Schnibbz/yeti-paw/cnc/yeti-paw-v1.3-yoke-CNC-drawing.pdf

BOTTOM face (engraved), as worn — legs up, eye down

yeti-paw-v1.3-yoke-CNC.step · mm (model frame: x along the U, y across)

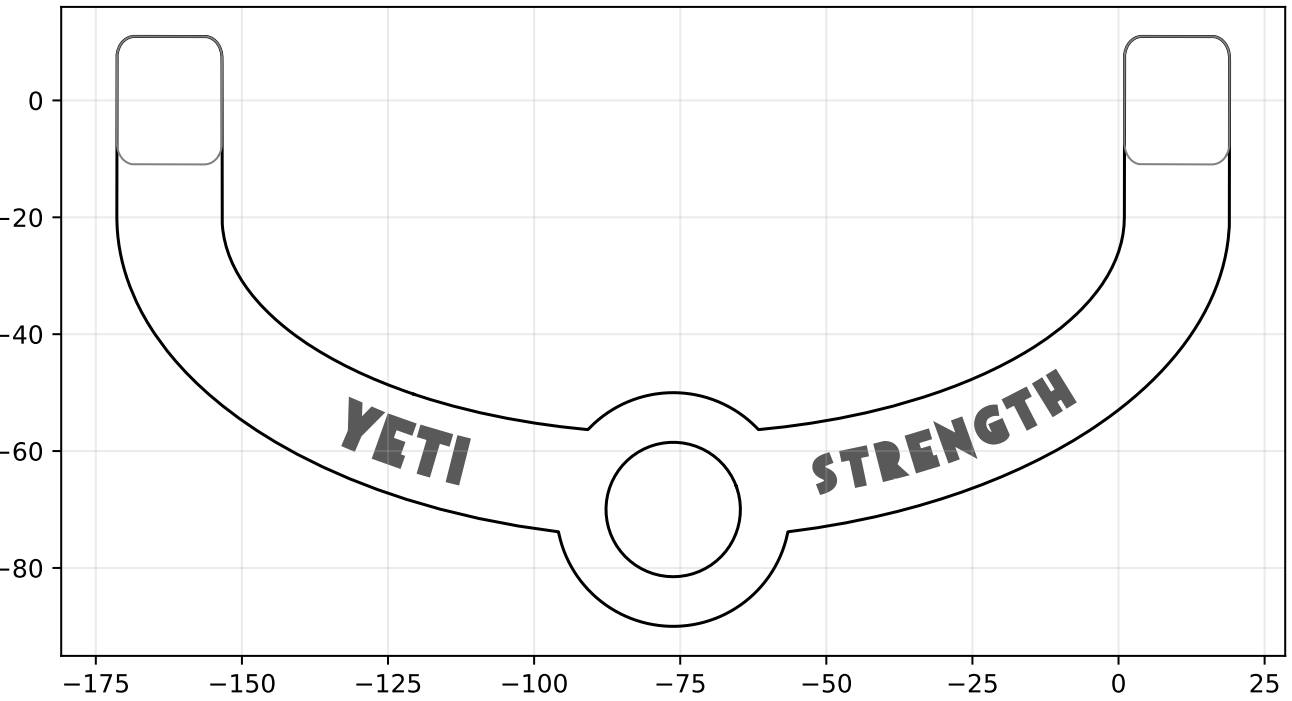
[picture p5: figure]

−25 | 0 | 25 | 50 | 75 | 100 | 125 | 150 | 175

0

20

Section through the pivot axis (x = 0) both Ø12 bores coaxial

Feature | Size | Notes
Pivot bores (2) | Ø12.000 P7 (11.971 / 11.989) | horizontal, through each boss, COAXIAL ±0.05
Pivot axis height | 13.00 from bottom face | boss Ø26, R3 end edges
Boss inner faces | 154.41 ±0.10 apart | sit 1 mm off the plates
Boss outer faces | 190.41 ±0.20
Eye bore | Ø23.000 P7 (22.965 / 22.986) | thru, centre 70.0 from pivot axis
Eye flange c'bore | Ø30.40 +0.10/0 × 1.60 deep | TOP face (opposite the engraving)
Band | 18 wide × 12.7 thick | R3 on every edge
YETI STRENGTH | engrave 0.30 ±0.05 | BOTTOM face, ≥ 2 mm off the radii

NOTES
1. Material: 6061-T6 aluminium. Overall 103 × 190.4 × 26 mm — from ≥ 28 mm (1-1/8" or 1-1/4") plate. Quantity 1.
2. Unless stated: ISO 2768-mK. Break all other edges 0.2–0.5 mm, no burrs. The R3 on every edge and the round bosses need 3D (ball-end) work on both faces;
a 4th axis or a side setup drills the two horizontal pivot bores — they MUST be coaxial (one setup, or line-bore).
3. Sleeves (purchased, same as the printed yoke): 2 × SF-1 steel-backed 12 × 10 × 20 in the pivot bores, pressed 1 mm proud of each boss face;
1 × bronze flanged 20 × 23 × 12, flange Ø30 × 1.5, in the eye, flange up in its counterbore. P7 bores = light press; bearing-retainer compound OK in aluminium.
4. Finish (optional): bead blast or tumble, then anodize Type II. Mask or hold the three sleeve bores after finishing; keep media out of them.
5. Engraving: YETI STRENGTH (Yeti Strength wordmark), 0.3 deep on the bottom face, reading as worn (legs up). Ø1 end mill or V-bit; strokes ≈ 1.5 mm.
6. Strength: at the 75 lb rating the yoke stress is ≈ 10 MPa (same FE as the printed yoke) → 6061-T6 static SF ≈ 28, fatigue SF ≈ 10.
The printed pad dowel still limits the rating to 75 lb. Not professionally engineered — use at your own risk.

YETI PAW v1.3 — carabiner yoke, CNC version (machined 6061-T6) Designed by Schnibbz · YETI STRENGTH
