Schnibbz/yeti-paw/cnc/yeti-paw-v1.3-plates-CNC-drawing.pdf

LEFT plate — OUTER face view (seats + engraving)

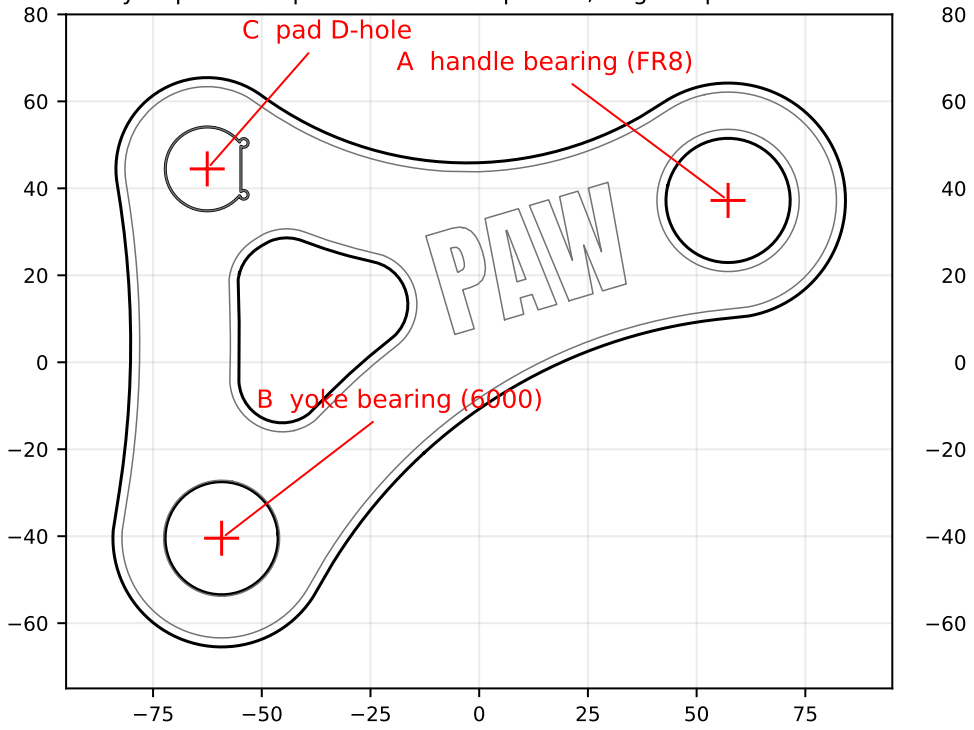
[picture p6: figure]
pad D-hole; B yoke bearing (6000); A handle bearing (FR8)

yeti-paw-v1.3-plate-left-CNC.step · mm, origin = part centre

RIGHT plate — OUTER face view (seats + engraving)

yeti-paw-v1.3-plate-right-CNC.step · mm, origin = part centre

Feature | Size | Depth from OUTER face
A FR8 flange c'bore | Ø32.05 +0.10/0 | 1.90 +0.05/0
A FR8 bearing seat | Ø28.575 K7 (28.560 / 28.581) | 7.94 +0.05/0

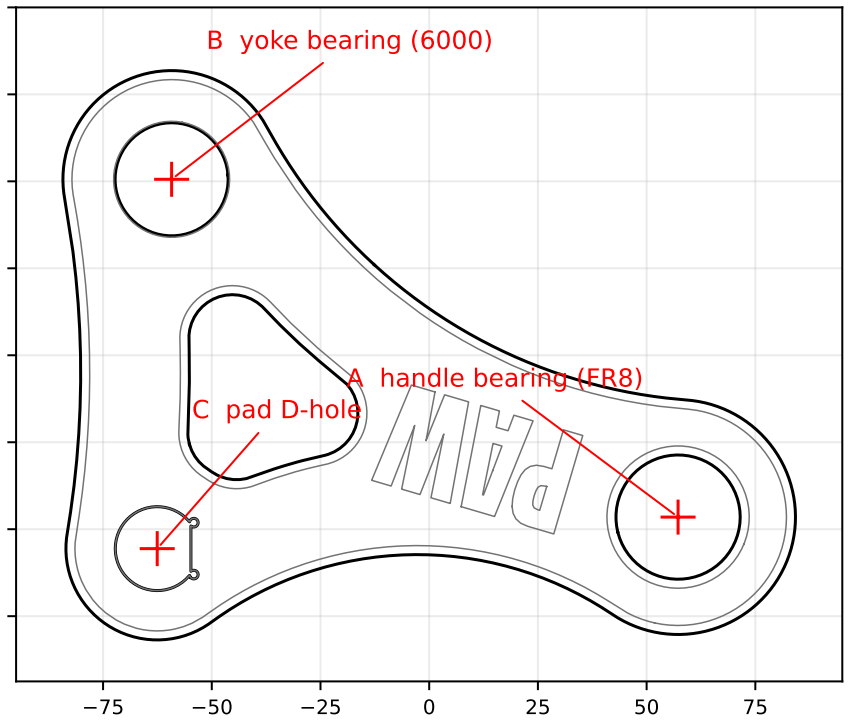
[picture p7: figure]
pad D-hole; B yoke bearing (6000); A handle bearing (FR8)

A through | Ø21.0 | thru
B 6000 bearing seat | Ø26.000 K7 (25.985 / 26.006) | 8.00 +0.05/0
B through | Ø17.0 | thru
A, B seat mouths | 0.5 × 45° lead-in | at outer face
C pad D-hole | Ø19.30 +0.10/0 | thru
C D flat | 7.75 +0.05/0 from hole centre | thru
C D corners | 2 × Ø2.0 relief (dogbone) | thru
Outline + window | R3 both faces
PAW logo | engrave | 0.30 ±0.05

Bearing-centre distances (functional, ±0.05):

A–C: 120.00

A–B: 140.00

B–C: 85.00

Bearings are pressed in from the OUTER face. Seat floors are flat, max corner radius 0.3 (the bearings' own edge chamfer). The FR8 locates on its seat floor, not on its flange.

NOTES
1. Material: 6061-T6 aluminium plate, 10.0 mm thick (±0.1). Do not substitute 3/8" (9.53 mm): the plate thickness sets the handle stack and the printed dowel's fit.
2. Quantity: 1 LEFT + 1 RIGHT. They are MIRROR IMAGES, not two of the same part.
3. Unless stated: ISO 2768-mK (±0.2 on most sizes, ±0.3 on the outline). Break all other edges 0.2–0.5 mm, no burrs, no sharp edges (the plates are handled and touch the forearm).
4. Edge radius: R3 on the outline and window, both faces. A 1 × 45° chamfer instead is acceptable if it saves a setup or cost — state it on the quote.
5. Finish (optional, quote separately): bead blast or vibratory tumble, THEN anodize Type II (black). Mask both bearing seats, or hold the seat sizes AFTER finishing:

anodizing grows the surface, which tightens a K7 seat. Keep tumbling media out of the seats.
6. Bearings: FR8-2RS (12.7 × 28.575 × 7.94, flange Ø31.75 × 1.6) in A; 6000-2RS (10 × 26 × 8) in B. Press square with an arbor press on the OUTER ring only.
7. Engraving: PAW, 0.3 deep. Strokes are > 2 mm wide; a Ø2 end mill or a V-bit is fine (inside corners may round).
8. These plates replace the printed side plates only. Everything else (printed yoke and pad dowel, hardware) is per the YETI PAW v1.3 BOM. The published safety factors
are for PETG-CF printed parts. Aluminium plates are much stronger, but the printed yoke and dowel still limit the rating to 75 lb. Not professionally engineered — use at your own risk.

YETI PAW v1.3 — side plates, CNC version (machined aluminium) Designed by Schnibbz · YETI STRENGTH
