Schnibbz/yeti-paw/BOM-yeti-paw.md

# YETI PAW v1.3 — Lateral Raise Handle — Bill of Materials

Designed by **Schnibbz** · YETI STRENGTH

> ## ⚠️ Parts changed in v1.3
> **Two parts are different from v1.2. Buy the new ones: the old ones don't fit the v1.3 files, and the new ones don't fit v1.2 prints.**
>
> | Part | v1.2 (old) | **v1.3 (new)** | Why |
> |---|---|---|---|
> | **Handle bearing** · 2 per handle · both plate variants | FR8-2RS **flanged**, 1/2" × 1-1/8" × 5/16" | **R8-2RS plain** (no flange), same 1/2" × 1-1/8" × 5/16" | The press fit alone holds the bearing; the flange did nothing. Cheaper, and the plate loses its flange pocket and the support it needed. |
> | **Carabiner eye sleeve** · 1 per yoke | uxcell **wrapped** flanged sleeve, 20 × 23 × 10 mm, Ø30 flange | **Solid bronze plain sleeve**, 3/4" bore × 7/8" OD × 1/2" long (McMaster **6391K256**) | The wrapped sleeve pressed in out of round and left the bottom edge of the eye bare plastic where the carabiner bears. The solid sleeve stays round and sits flush on both faces, so the carabiner only touches bronze. |
>
> **Don't mix versions.** v1.3 plates have no flange pocket, so an FR8 won't seat flush. The v1.3 yoke's eye bore is Ø22.39 for the 7/8" sleeve:
> the old 23 mm sleeve won't press in, and the new sleeve would be loose in a v1.2 yoke. Everything else is unchanged.

## What it costs

| | One Yeti Paw | A pair (both arms) |
|---|---|---|
| **Parts cost, pro-rated** — what the parts in one unit cost; packs split across the units they build; no tax; raw handles | **≈ $72** | **≈ $144** |
| **Cash to buy everything for a pair** — whole packs, no tax, plenty of hardware and filament left over | — | **≈ $217** |
| **What my first batch actually cost** — 4 units, real receipts, incl. tax and anodized handles | **$86.22** | **$172.44** |

How the first batch got from ≈ $72 of parts per unit to $86.22: sales tax, anodized handles instead of raw ($58 vs $48 a pair), and the
spare bearings, nuts, sleeves and ~600 g of filament left over from whole packs. Prices are approximate, checked 2026-10-13 for v1.2, and will drift. They have not been re-priced for v1.3's two part changes (the R8 bearing is cheaper; the bronze sleeve adds a McMaster-Carr order).

**Assumes free Rogue shipping**: Rogue ships free once your cart has 3 ship-free items, so add the handles to a bigger Rogue
order (or a friend's). Other shipping is included in the parts cost: Bolt Depot economy $12.12 and aluminumspacers.com $10
flat, both split across a pair. Amazon is free over $35.

Quantities below are **per Yeti Paw** (one handle). Double them for a pair.

## Amazon

*Amazon links are affiliate links (I earn a small commission at no extra cost to you). Prices change, so they aren't listed.*

| Part | Qty | Pack | Link |
|---|---|---|---|
| **Handle bearing** · *changed in v1.3*<br><sub>R8-2RS plain ball bearing (no flange), 1/2" bore × 1-1/8" OD × 5/16" — Sackorange 10-pack</sub> | 2 | 10 | [B07DCQLCS3](https://www.amazon.com/dp/B07DCQLCS3?tag=yetistrength-20) |
| **Yoke bearing**<br><sub>6000-2RS ball bearing, 10 × 26 × 8 mm</sub> | 2 | 10 | [B0DTKDKSTF](https://www.amazon.com/dp/B0DTKDKSTF?tag=yetistrength-20) |
| **Yoke compression sleeve**<br><sub>SF-1 1020 bushing, 10 × 12 × 20 mm</sub> | 2 | 10 | [B07FPH25F3](https://www.amazon.com/dp/B07FPH25F3?tag=yetistrength-20) |
| **Yoke lock nut**<br><sub>M8 × 1.25 nylon-insert, DIN 985, black oxide</sub> | 2 | 25 | [B083Z2GCRR](https://www.amazon.com/dp/B083Z2GCRR?tag=yetistrength-20) |
| **Yoke washer**<br><sub>M8 flat washer, 8 × 12 × 0.8 mm, 304 stainless</sub> | 2 | 20 | [B0DP6Y9MQP](https://www.amazon.com/dp/B0DP6Y9MQP?tag=yetistrength-20) |
| **Wrist pad**<br><sub>CONCAVE foam roller pad, 2.95" OD × 5.71", 0.87" bore — trim evenly from both ends to 132 mm</sub> | 1 | 2 | [B094D5ZJXK](https://www.amazon.com/dp/B094D5ZJXK?tag=yetistrength-20) |
| **Threadlocker**<br><sub>Loctite 243 blue, 6 mL — handle screws only</sub> | a drop | 1 | [B004L439FE](https://www.amazon.com/dp/B004L439FE?tag=yetistrength-20) |
| **Body filament**<br><sub>ELEGOO PETG-CF, black, 1.75 mm</sub> | ≈ 350 g | 1 kg | [B0F37YCK6K](https://www.amazon.com/dp/B0F37YCK6K?tag=yetistrength-20) |
| **Logo filament**<br><sub>SUNLU PETG, white, 1.75 mm</sub> | ≈ 18 g | 1 kg | [B085TH48N6](https://www.amazon.com/dp/B085TH48N6?tag=yetistrength-20) |

## McMaster-Carr

| Part | Qty | Pack | Link |
|---|---|---|---|
| **Carabiner eye sleeve** · *changed in v1.3*<br><sub>Oil-embedded SAE 841 bronze sleeve bearing, 3/4" bore × 7/8" OD × 1/2" long — bronze, not the iron-copper version</sub> | 1 | each | [6391K256](https://www.mcmaster.com/6391K256/) |

## Bolt Depot

Screws and bolts are black oxide; the pad washer is black-oxide stainless. Economy shipping was **$12.12** on a real order.

| Part | Qty | Unit price | Link |
|---|---|---|---|
| **Handle screw**<br><sub>Socket button head 1/2"-13 × 1-1/4", alloy steel</sub> | 2 | $0.87 | [#13198](https://boltdepot.com/Product-Details?product=13198) |
| **Pad screw**<br><sub>Socket button head 1/2"-13 × 2", FULL THREAD, alloy steel</sub> | 2 | $1.38 | [#13201](https://boltdepot.com/Product-Details?product=13201) |
| **Pad washer**<br><sub>Flat washer 1/2", 18-8 stainless, black oxide, 1-1/4" OD</sub> | 2 | $0.43 | [#22033](https://boltdepot.com/Product-Details?product=22033) |
| **Yoke pivot**<br><sub>Shoulder bolt ISO 7379, Ø10 × 25 mm shoulder, M8 × 1.25, class 12.9</sub> | 2 | $2.34 | [#14248](https://boltdepot.com/Product-Details?product=14248) |

Parts **$10.04** per Yeti Paw; a pair is $20.08 + $12.12 shipping = **$32.20**.

## aluminumspacers.com

**$10 flat shipping.** Order by phone; their web checkout was broken as of Oct 2026.

| Part | Qty | Unit price | Link |
|---|---|---|---|
| **Handle spacer**<br><sub>Round spacer, 6061-T6, 0.509" ID × 0.625" OD × 0.188"</sub> | 4 | $1.31 (25+ @ $0.82) | [AS62-22-12](https://www.aluminumspacers.com/spacers-by-hole-size/hole-for-1-2-inch-bolts/1-2-id-5-8-od/as62-22-12) |

A pair is 8 × $1.31 + $10 = **$20.48**.

## Rogue Fitness

| Part | Qty | Unit price | Link |
|---|---|---|---|
| **Handle**<br><sub>Rogue H-5, 45 mm straight × 5", 1/2"-13 both ends — sold as a pair</sub> | 1 | $24 ($48 / pair, raw) | [Rogue H-5](https://www.roguefitness.com/rogue-h-5-multi-grip-and-cable-attachment-handles) |

One pair of handles builds a pair of Yeti Paws. **Shipping is free once the cart has 3 ship-free items**; the prices here
assume you get that.

## Printed parts

Bambu Studio projects, one per print: [side plates](https://github.com/Schnibbz/yeti-paw/raw/main/yeti-paw-v1.3-plates-PROJECT.3mf) (both on one bed),
[yoke](https://github.com/Schnibbz/yeti-paw/raw/main/yeti-paw-v1.3-yoke-PROJECT.3mf) and [pad dowel](https://github.com/Schnibbz/yeti-paw/raw/main/yeti-paw-v1.3-dowel-PROJECT.3mf).
STL files and settings for any other printer: [`stl/`](stl/) and [`PRINT-SETTINGS.md`](PRINT-SETTINGS.md).

| Part | Qty | Material | Print time |
|---|---|---|---|
| Side plates, left + right (PAW logo), one bed | 1 pair | PETG-CF + white PETG logo · 6 walls, 40 % gyroid | ≈ 7.7 h |
| Carabiner yoke (YETI STRENGTH, both faces) | 1 | PETG-CF + white PETG lettering · 100 % infill | ≈ 3.2 h |
| Pad dowel | 1 | PETG-CF · 100 % infill · PLA for the support interface only (about 1 g) | ≈ 3.9 h |

## Not included

A steel screw-gate carabiner, rated 25 kN or more. Its bar must pass through a 20 mm hole.

## Tools

- Hex keys: 5 mm and 5/16".
- 13 mm wrench.
- Inch-pound torque driver: 35 in-lb for the yoke nylocks.
- Foot-pound torque wrench: about 10 ft-lb, never more than 15, for the handle screws.
- Ø12 mm drill bit, turned by hand, to clean the yoke pivot bores.
- Bench vise or clamp, to press in the bearings and sleeves.
- Fine sandpaper, a deburring tool (for the spacer chamfer) and a little wax (for the dowel threads).
- Sharp knife or fine saw, to trim the pad to 132 mm.
- Light oil for the black-oxide hardware.

---

**Not professionally engineered.** The Yeti Paw was designed by a hobbyist, not by a licensed or qualified engineer. Any
strength or safety-factor figures are amateur estimates from a simplified computer model. They are not a certified load
rating and come with no guarantee.

**Build and use at your own risk.** You are responsible for printing, assembling, inspecting and using this device. Print
quality, materials, settings and assembly vary, so your parts may be weaker than described. Inspect every part before each
use, and stop using it at the first sign of cracking, play or damage. The designer accepts no liability for injury or
damage arising from building or using it.

---

**Disclosure:** The Amazon links on this page are affiliate links. If you buy through them, I earn a small commission on the
sale, at no extra cost to you. As an Amazon Associate I earn from qualifying purchases.
