Schnibbz/yeti-paw/cnc/yeti-paw-v1.3-yoke-CNC.step

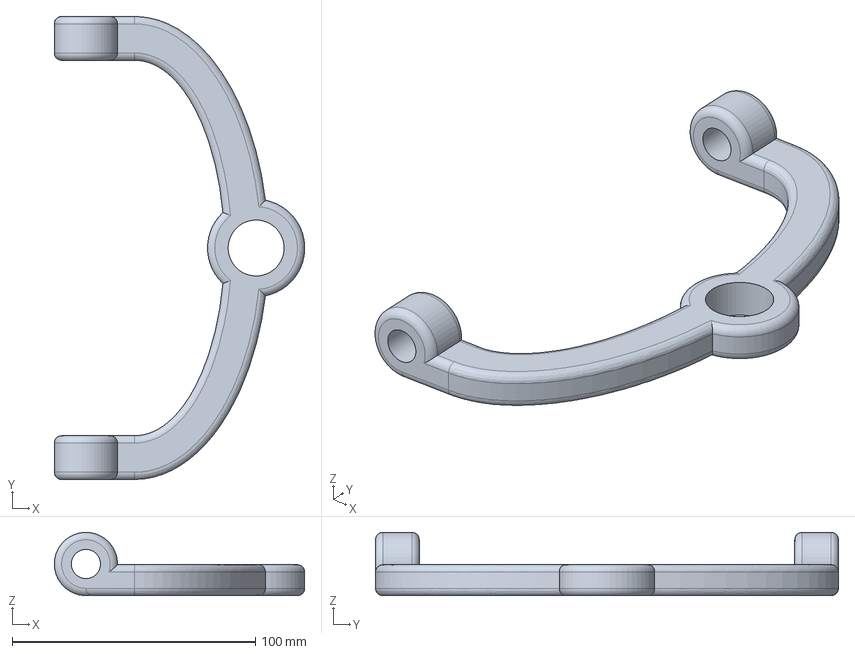
[picture p39: CAD file, 2026-10-19]
cnc/yeti-paw-v1.3-yoke-CNC.step
103.0 x 190.4 x 26.0 mm
