Schnibbz/yeti-paw/cnc/yeti-paw-v1.3-plate-left-CNC.step

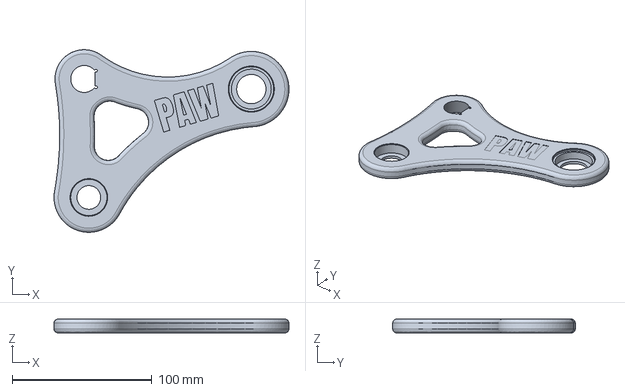
[picture p40: CAD file, 2026-10-17]
cnc/yeti-paw-v1.3-plate-left-CNC.step
168.4 x 130.9 x 10.0 mm
