Schnibbz/yeti-paw/step/yeti-paw-v1.3-centered-plate-right.step

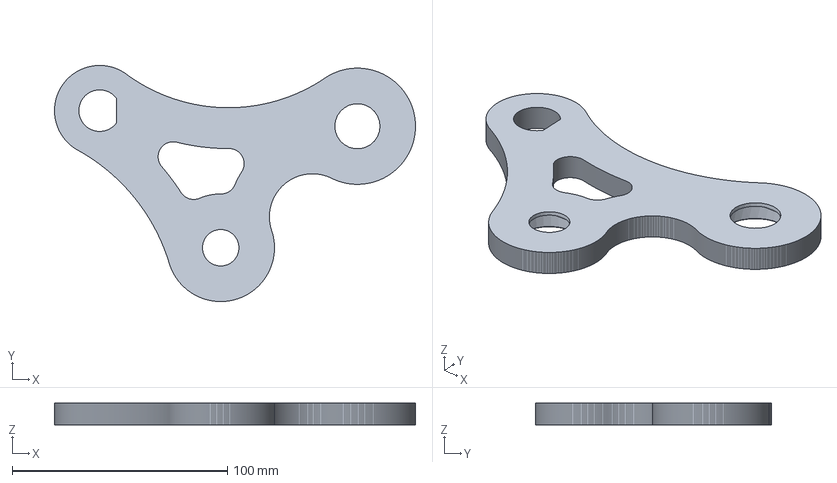
[picture p41: CAD file, 2026-10-17]
step/yeti-paw-v1.3-centered-plate-right.step
167.8 x 109.7 x 10.0 mm
