Schnibbz/yeti-paw/yeti-paw-v1.3-centered-plates-PROJECT.3mf

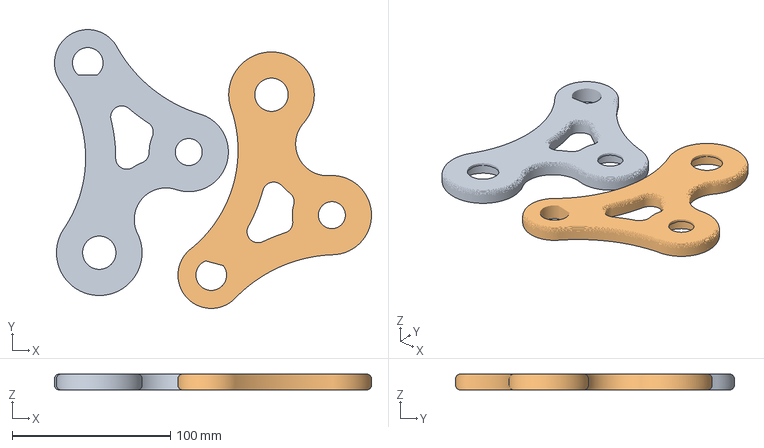
[picture p42: CAD file, 2026-10-17]
yeti-paw-v1.3-centered-plates-PROJECT.3mf
200.0 x 175.9 x 10.0 mm
