Schnibbz/yeti-paw/yeti-paw-v1.3-dowel-PROJECT.3mf

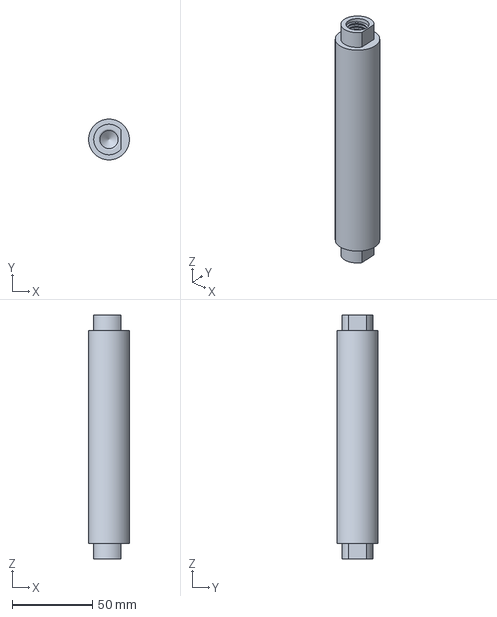
[picture p43: CAD file, 2026-10-17]
yeti-paw-v1.3-dowel-PROJECT.3mf
25.4 x 25.4 x 151.8 mm
