Schnibbz/yeti-paw/yeti-paw-v1.3-plates-PROJECT.3mf

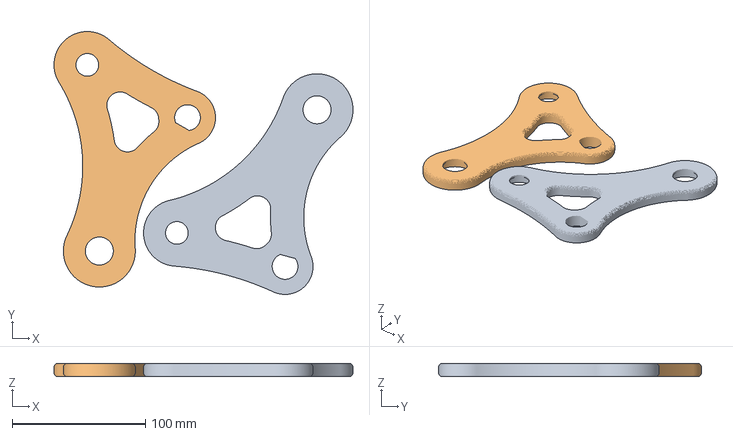
[picture p44: CAD file, 2026-10-17]
yeti-paw-v1.3-plates-PROJECT.3mf
224.4 x 197.3 x 10.0 mm
