Schnibbz/yeti-paw/step/yeti-paw-v1.3-plate-left.step

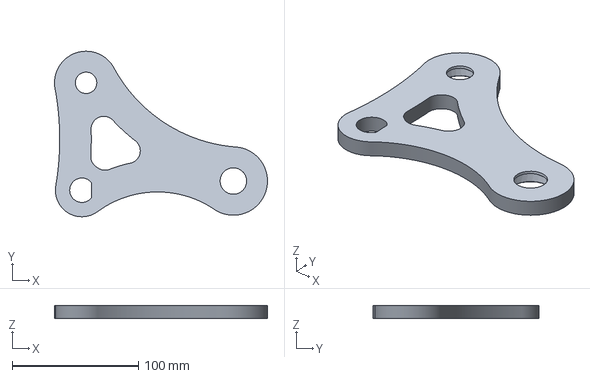
[picture p45: CAD file, 2026-10-17]
step/yeti-paw-v1.3-plate-left.step
168.5 x 130.9 x 10.0 mm
