Schnibbz/yeti-paw/(list of files, cad)

Other CAD files:
step/yeti-paw-v1.3-carabiner-yoke.step
yeti-paw-v1.3-yoke-PROJECT.3mf
cnc/yeti-paw-v1.3-plate-right-CNC.step
step/yeti-paw-v1.3-centered-plate-left.step
step/yeti-paw-v1.3-pad-dowel.step
step/yeti-paw-v1.3-plate-right.step
cnc/yeti-paw-v1.2-plate-left-CNC.step
cnc/yeti-paw-v1.2-plate-right-CNC.step
step/yeti-paw-v1.2-plate-left.step
step/yeti-paw-v1.2-plate-right.step
step/yeti-paw-v1.2-pad-dowel.step
stl/yeti-paw-v1.3-carabiner-yoke.stl
stl/yeti-paw-v1.3-centered-plate-left.stl
stl/yeti-paw-v1.3-centered-plate-right.stl
stl/yeti-paw-v1.3-pad-dowel.stl
stl/yeti-paw-v1.3-plate-left.stl
stl/yeti-paw-v1.3-plate-right.stl
