Schnibbz/yeti-paw/yeti-paw-assembly-sheets.pdf

# YETI PAW v1.3

## Lateral raise handle — assembly sheets

## Designed by Schnibbz · YETI STRENGTH

### 1 · Overview (assembled) 2 · Handle assembly 3 · Yoke assembly 3b · Yoke pivot — section 4 · Pad assembly

v1.3: two parts changed. The drawings in sheets 2 and 3 still show the v1.2 parts.
Handle bearing: use the plain R8-2RS (no flange), not the flanged FR8 drawn in sheet 2. Press it in from the outer face until it stops on the ledge behind the seat; its face ends flush with the plate.
Carabiner eye sleeve: use the solid bronze plain sleeve, McMaster 6391K256 (3/4" bore × 7/8" OD × 1/2" long), not the flanged sleeve drawn in sheet 3. Press it through the eye until it sits flush with both faces.

Before you start: print the parts with the settings in PRINT-SETTINGS.md. Clean the yoke's two Ø12 pivot bores back to round with a Ø12 mm drill bit turned by hand. Run a 1/2"-13 bolt through both dowel threads. Bearings and sleeves are press fits: no Loctite or CA glue on plastic (it attacks PETG); epoxy is OK if a bearing seat is loose. Blue Loctite goes on the handle screws only, which are metal into metal. Assembly order: see the README.

Not professionally engineered. The Yeti Paw was designed by a hobbyist, not by a licensed or qualified engineer. Any strength or safety-factor figures are amateur estimates from a simplified computer model, not a certified load rating, and come with no guarantee.

Build and use at your own risk. You are responsible for printing, assembling, inspecting and using this device. Print quality, materials, settings and assembly vary, so your parts may be weaker than described. Inspect every part before each use and stop using it at the first sign of cracking, play or damage. The designer accepts no liability for injury or damage arising from building or using it.

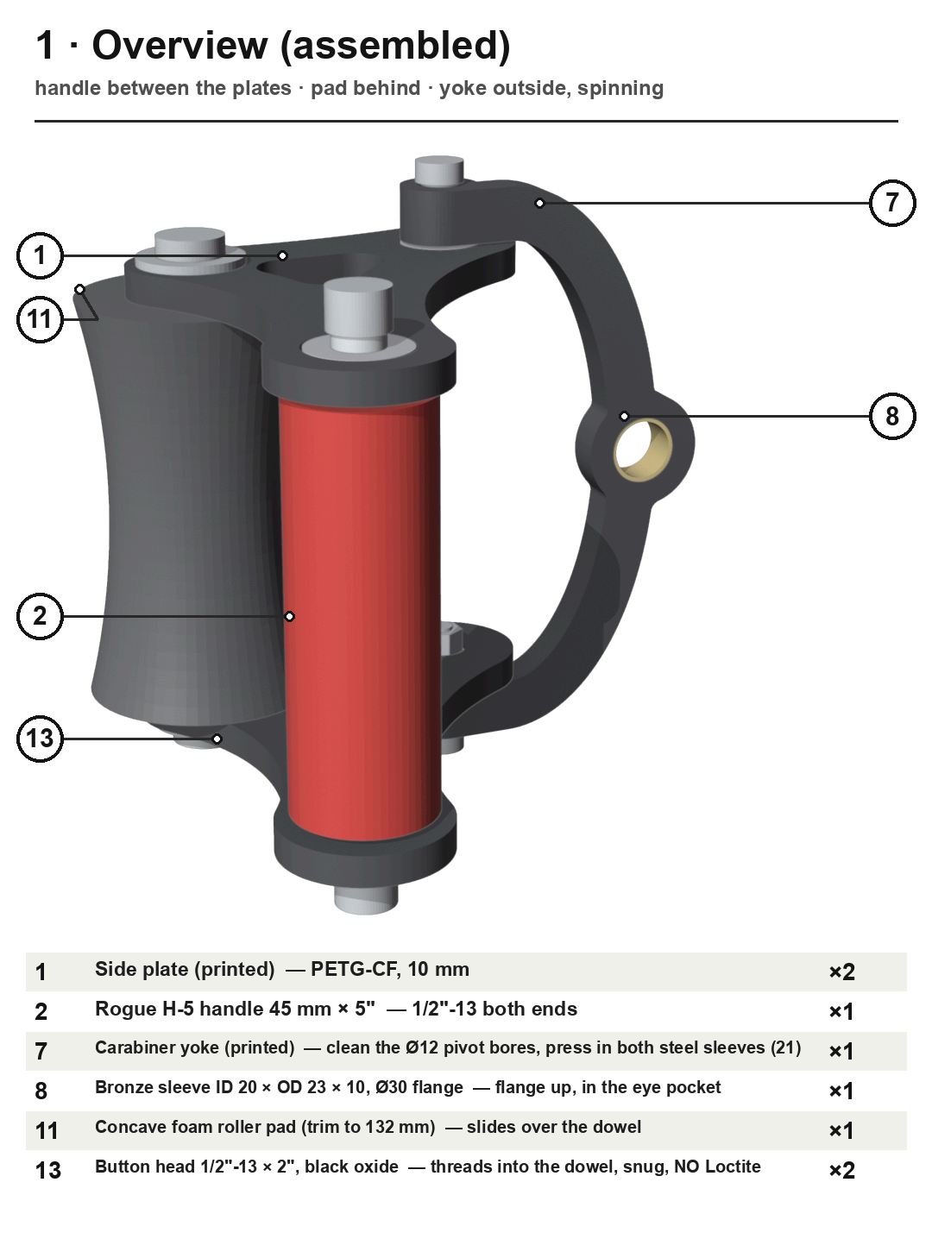
[picture p46: page 2]

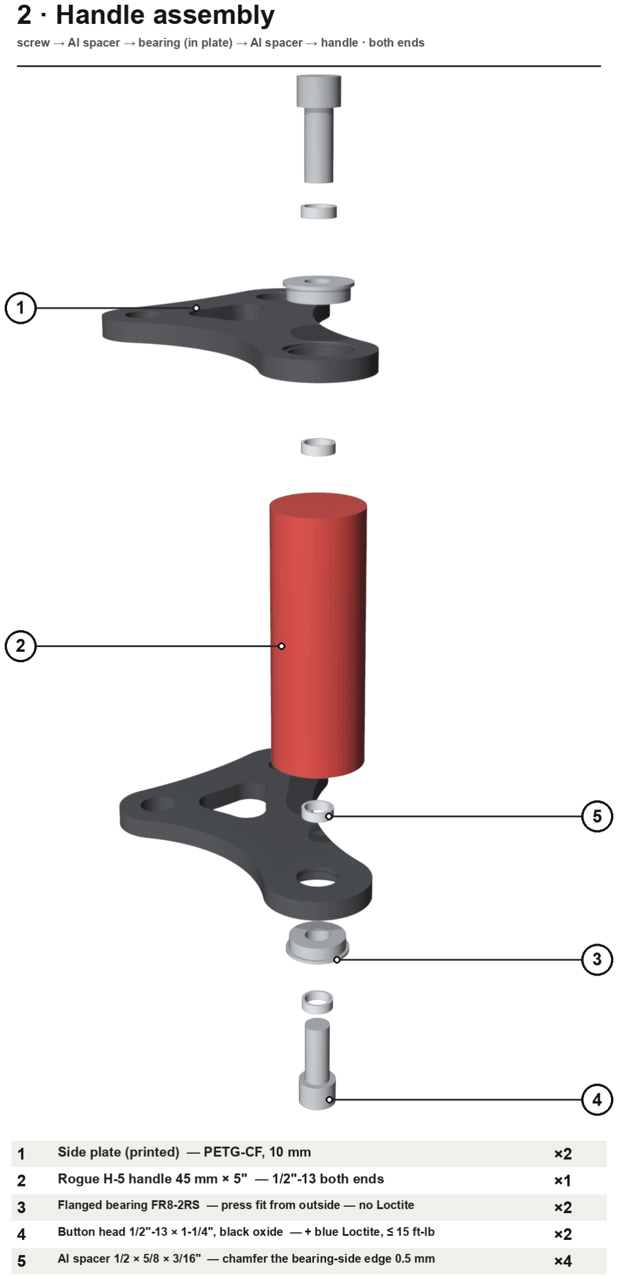
[picture p47: figure]

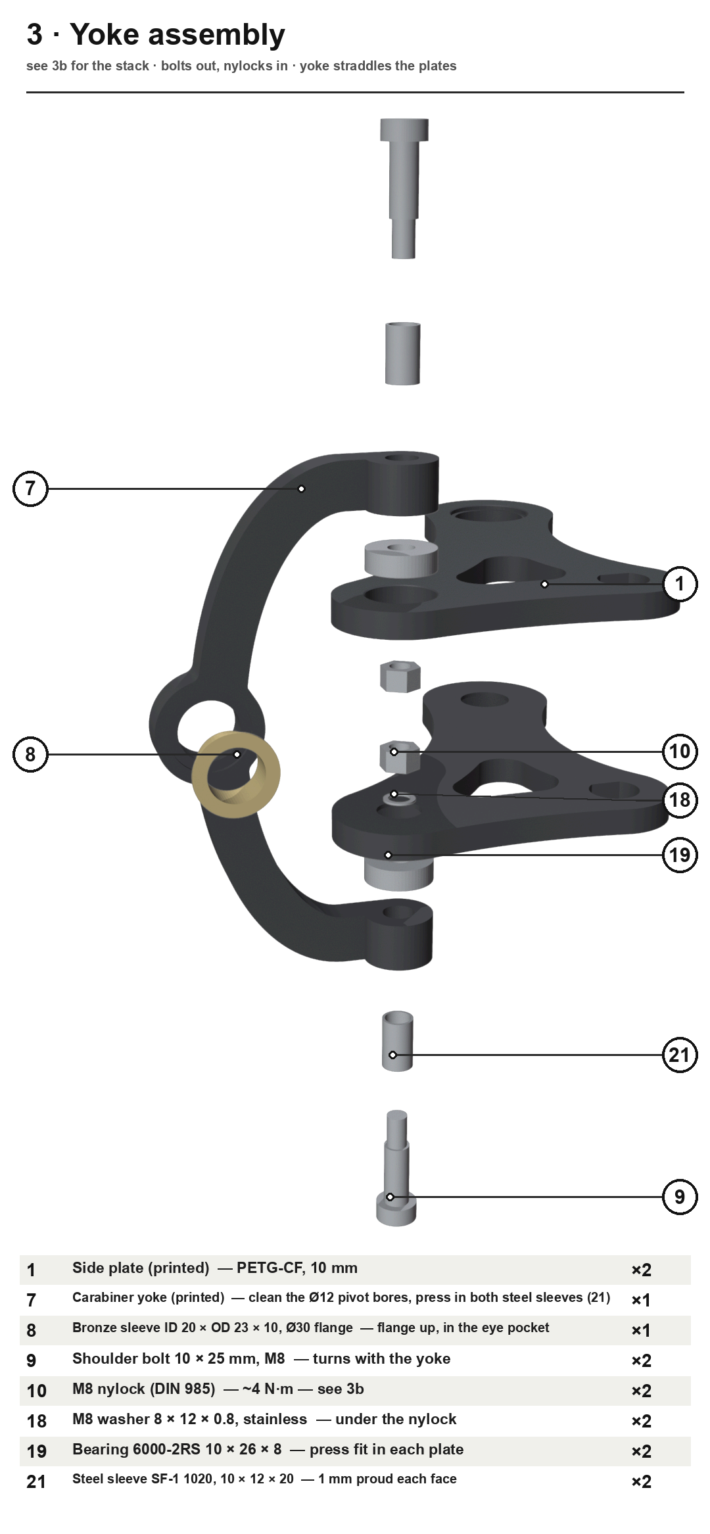
[picture p48: figure]

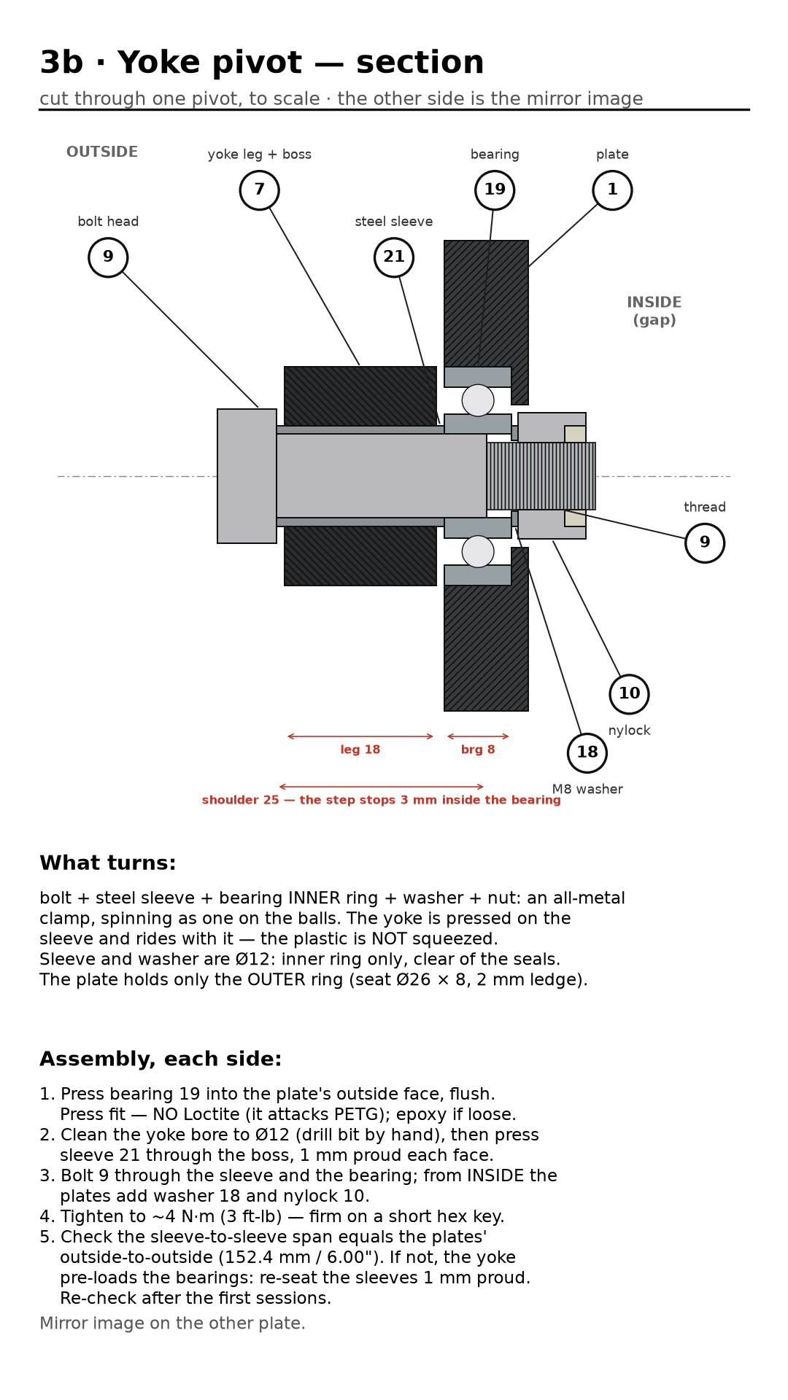
[picture p49: figure]
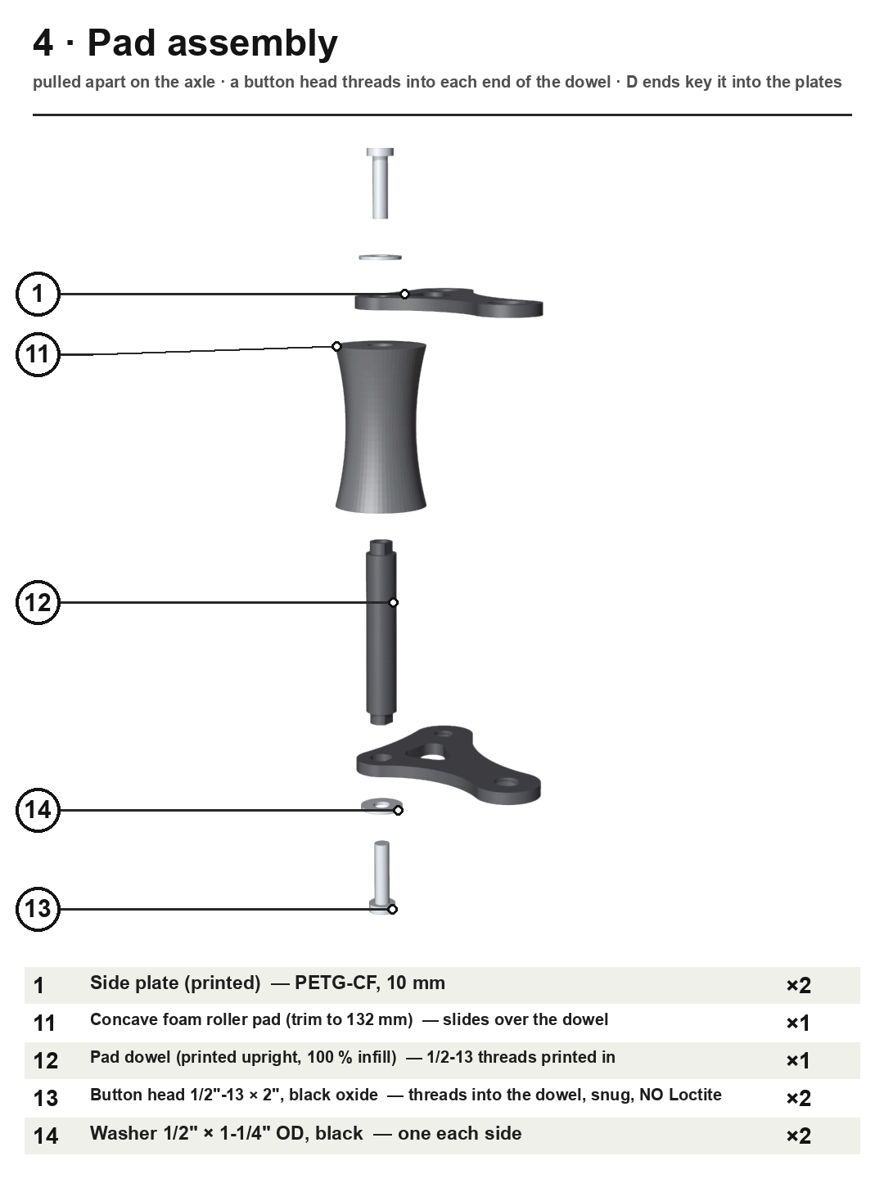
[picture p50: page 6]
