Schnibbz/yeti-paw/(commit log)

2026-10-13 YETI PAW v1.1 — first public release
    [yeti-paw-v1.1-PROJECT.3mf, yeti-paw-v1.1-carabiner-yoke.stl, yeti-paw-v1.1-pad-dowel.stl, yeti-paw-v1.1-plate-left.stl, yeti-paw-v1.1-plate-right.stl]
2026-10-13 v1.1 project: yoke supports only under the two pivot bosses (were all round the part)
    [yeti-paw-v1.1-PROJECT.3mf]
2026-10-13 fix: yoke lies FLAT on its band face (it was printing tilted, ~34 mm² bed contact → lifted); supports under the pivot bosses only; yoke STL re-exported
    [yeti-paw-v1.1-PROJECT.3mf, yeti-paw-v1.1-carabiner-yoke.stl]
2026-10-14 project: pad dowel shoulder support snug (no support scar round the body)
    [yeti-paw-v1.1-PROJECT.3mf]
2026-10-14 v1.2: new carabiner yoke (3 mm radius on every edge, 100 % infill), yoke support and first-layer settings, safety factors re-run (rating stays 75 lb)
    [yeti-paw-v1.1-PROJECT.3mf, yeti-paw-v1.1-carabiner-yoke.stl, yeti-paw-v1.2-PROJECT.3mf, yeti-paw-v1.2-carabiner-yoke.stl, yeti-paw-v1.2-pad-dowel.stl, yeti-paw-v1.2-plate-left.stl, yeti-paw-v1.2-plate-right.stl]
2026-10-14 Add STEP files for the four printed parts
    [yeti-paw-v1.2-carabiner-yoke.step, yeti-paw-v1.2-pad-dowel.step, yeti-paw-v1.2-plate-left.step, yeti-paw-v1.2-plate-right.step]
2026-10-14 CNC option: machined aluminium side plates (STEP + shop drawing + ordering/finishing notes)
    [yeti-paw-v1.2-plate-left-CNC.step, yeti-paw-v1.2-plate-right-CNC.step]
2026-10-15 Yoke-only project with the printed-and-checked yoke settings; fix: main v1.2 project now really contains the v1.2 yoke (the previous upload had the v1.1 yoke)
    [yeti-paw-v1.2-PROJECT.3mf, yeti-paw-v1.2-yoke-PROJECT.3mf]
2026-10-15 CNC aluminium yoke (STEP + shop drawing, YETI STRENGTH engraved); yoke STEP now carries the YETI STRENGTH engraving; CNC notes cover plates and yoke
    [yeti-paw-v1.2-carabiner-yoke.step, yeti-paw-v1.2-yoke-CNC.step]
2026-10-15 One YETI PAW = three projects: side plates (L + R on one bed, anti-curl), yoke (locked settings, YETI STRENGTH painted), pad dowel; bearing seats +0.05; STL/STEP/CNC regenerated (YETI re-centred); do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
    [yeti-paw-v1.2-PROJECT.3mf, yeti-paw-v1.2-carabiner-yoke.step, yeti-paw-v1.2-dowel-PROJECT.3mf, yeti-paw-v1.2-pad-dowel.step, yeti-paw-v1.2-plate-left.step, yeti-paw-v1.2-plate-left.stl, yeti-paw-v1.2-plate-right.step, yeti-paw-v1.2-plate-right.stl]
2026-10-16 Yoke: locked settings that printed excellent in PETG-CF — support only the flat bottom and rounded ends of each pivot boss, concentric ironed interface, 245 °C, overhang cooling; PRINT-SETTINGS updat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
    [yeti-paw-v1.2-dowel-PROJECT.3mf, yeti-paw-v1.2-yoke-PROJECT.3mf]
2026-10-16 Pad dowel: PLA support interface under the shoulder (zero gap) — flat shoulder, clean peel; BOM printed-parts table and PRINT-SETTINGS updated
    [yeti-paw-v1.2-dowel-PROJECT.3mf]
2026-10-16 Centered-pivot side plates (optional variant): yoke hole centered between handle and pad, load shared more evenly between hand and wrist; project, STL, STEP, hero render; safety factors (≈5 % stronge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
    [yeti-paw-v1.2-centered-plate-left.step, yeti-paw-v1.2-centered-plate-left.stl, yeti-paw-v1.2-centered-plate-right.step, yeti-paw-v1.2-centered-plate-right.stl, yeti-paw-v1.2-centered-plates-PROJECT.3mf]
2026-10-16 Centered-pivot plates: own safety-factor page (md + PDF) with a side-by-side against the standard plate; README links it; status note removed
2026-10-17 YETI PAW v1.3: two parts changed (plain R8-2RS handle bearing on both plate variants; solid bronze eye sleeve, McMaster 6391K256); centered plates swept R20; all print/CAD/CNC files, BOM, print setti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
    [yeti-paw-v1.2-carabiner-yoke.step, yeti-paw-v1.2-carabiner-yoke.stl, yeti-paw-v1.2-centered-plate-left.step, yeti-paw-v1.2-centered-plate-left.stl, yeti-paw-v1.2-centered-plate-right.step, yeti-paw-v1.2-centered-plate-right.stl, yeti-paw-v1.2-centered-plates-PROJECT.3mf, yeti-paw-v1.2-dowel-PROJECT.3mf]
2026-10-17 Corrections after review: centered-plate swing covers all four movements only at the modeled stances (close-stance Bayesian curls and flies can reach the stop); strength wording 'matches the standard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
2026-10-17 v1.3.1: centered-pivot plates' PAW logo re-centered (visible gaps 11.3 above / 11.2 below / 8.0 window / 8.0 handle hole); project, STLs, STEPs and hero updated; cosmetic, no part changes
    [yeti-paw-v1.3-centered-plate-left.step, yeti-paw-v1.3-centered-plate-left.stl, yeti-paw-v1.3-centered-plate-right.step, yeti-paw-v1.3-centered-plate-right.stl, yeti-paw-v1.3-centered-plates-PROJECT.3mf]
2026-10-19 v1.3.2: yoke eye bore Ø22.39, set by a printed press-fit ladder with the McMaster 6391K256 bronze sleeve; yoke project, STL, STEP, CNC and docs updated
    [yeti-paw-v1.3-carabiner-yoke.step, yeti-paw-v1.3-carabiner-yoke.stl, yeti-paw-v1.3-yoke-CNC.step, yeti-paw-v1.3-yoke-PROJECT.3mf]
2026-10-24 v1.3.3: carabiner yoke YETI STRENGTH on both faces (mirrored top face); prime tower at the bed centre; print settings, BOM, changelog
    [yeti-paw-v1.3-yoke-PROJECT.3mf]
